sunnyyue000/Guitar-Pedal-Project/README.md

# Guitar Pedal Project

## Project Summary

This project aimed to design and create the circuit for an overdrive/distortion effects unit. This pedal is an op-amp based overdrive, with the unique feature of being able to switch between a warm overdrive tone, and a gritty distortion tone.

## Contents 

This Repository contains the multisim file, as well as the gerber files for the PCB of the design. It also contains a document detailing the design process and electrical analysis for the project.
