sunnyyue000/Guitar-Pedal-Project/(list of files, drawings)

Other design files:
Pedal A multisim.ms14
